lnminh1411/ESP32-Human-Presence-Radar/docs/images/pcb_base_silkscreen_bottom.png

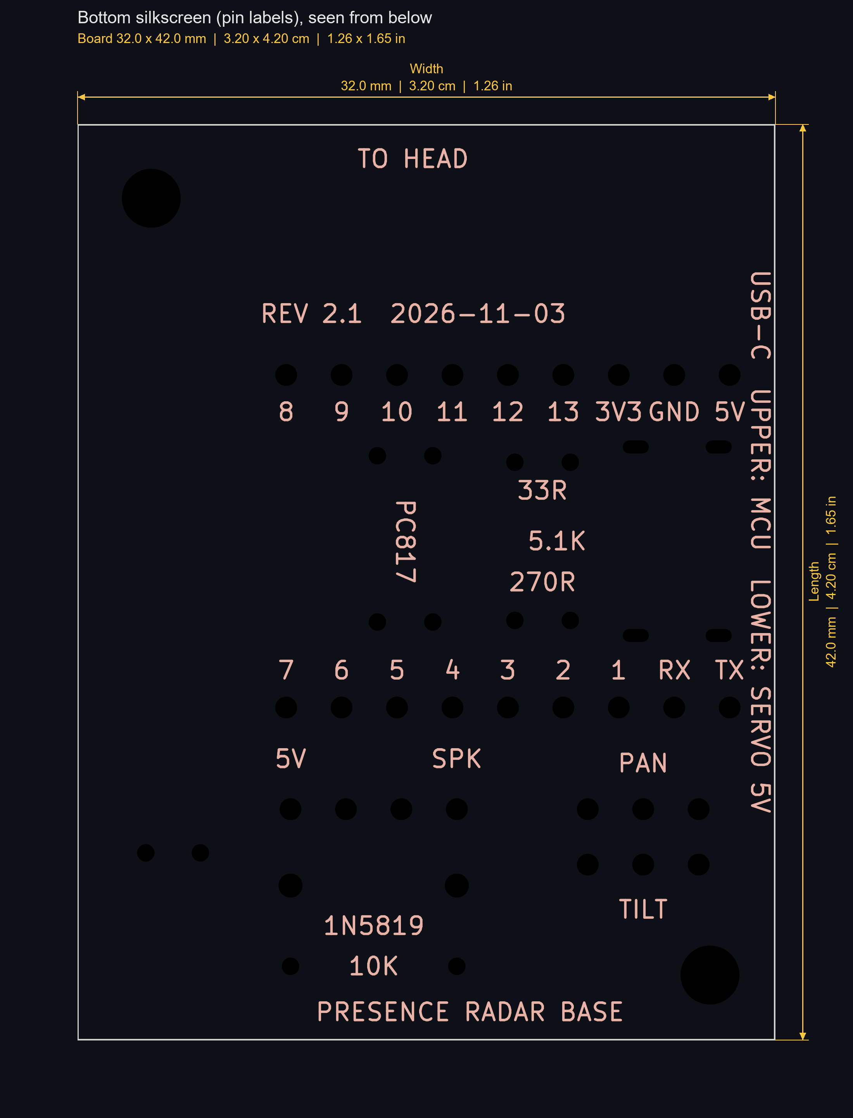
docs/images/pcb_base_silkscreen_bottom.png
