lnminh1411/ESP32-Human-Presence-Radar/docs/images/pcb_head_3d_sensor_side.png

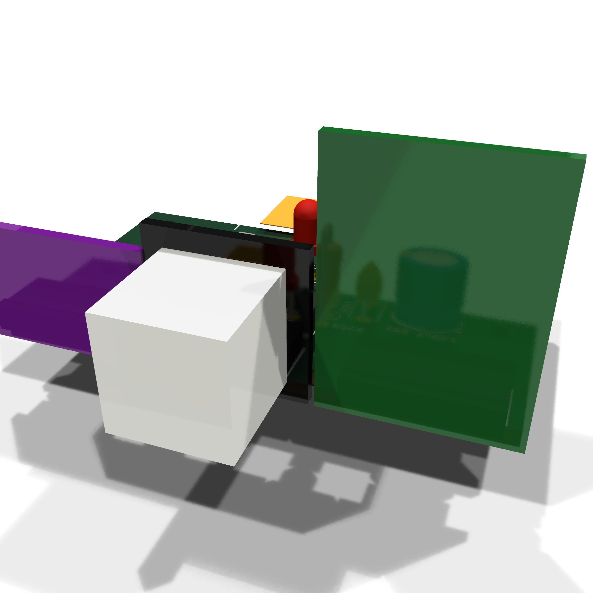
docs/images/pcb_head_3d_sensor_side.png
