lnminh1411/ESP32-Human-Presence-Radar/pcb/layouts/default/default.kicad_pcb

## KiCad design pcb/layouts/default/default.kicad_pcb (2026-11-03)

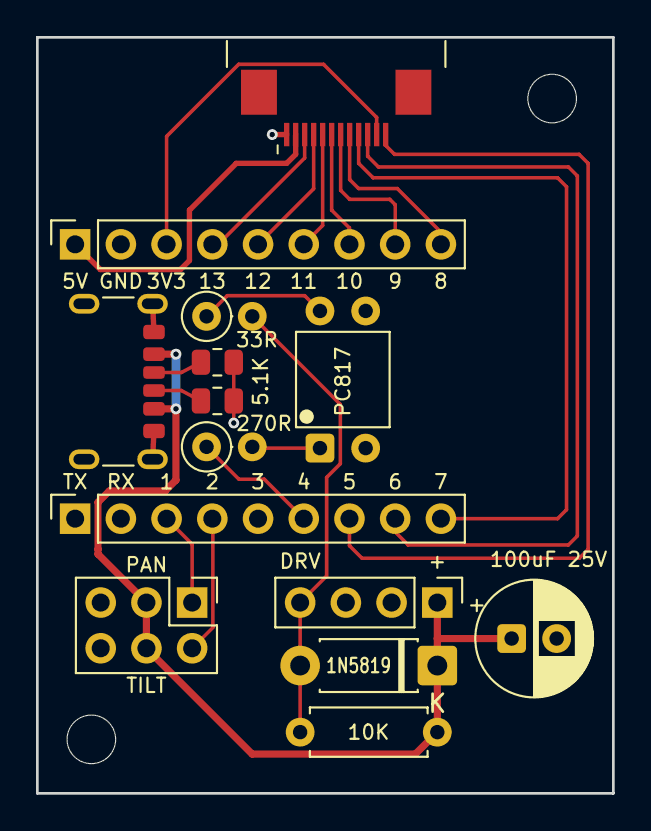
[picture p7: board default.kicad_pcb from above]

Board: 2 copper layers, 32.0 x 42.0 mm, 17 parts (0 on the bottom side), 21 nets.

Parts:
C1: 100u 25V; CP_Radial_D6.3mm_P2.50mm
D1: 1N5819; D_DO-41_SOD81_P7.62mm_Horizontal
FIT1: (no value)
J1, J2: main.ato:Socket1x9; PinSocket_1x09_P2.54mm_Vertical
J3: main.ato:Ffc12; FFC_P0.50mm_1x12_FlipLock_Bottom
J4: main.ato:ServoHeader2x3; PinHeader_2x03_P2.54mm_Vertical
J5: main.ato:UsbC6P; USB_C_Receptacle_GCT_USB4125-xx-x_6P_TopMnt_Horizontal
J6: main.ato:SpeakerHeader; PinHeader_1x04_P2.54mm_Vertical
MH1, MH2: MountingHole_2.7mm_M2.5
R1: 270; R_Axial_DIN0207_L6.3mm_D2.5mm_P2.54mm_Vertical
R2: 33; R_Axial_DIN0207_L6.3mm_D2.5mm_P2.54mm_Vertical
R3: 10k; R_Axial_DIN0207_L6.3mm_D2.5mm_P7.62mm_Horizontal
R4, R5: 5.1k; R_0805_2012Metric
U1: PC817; DIP-4_W7.62mm

Connections:
beep: J2.6, R1.1
beep_led: R1.2, U1.1
cc1: J5.A5, R4.1
cc2: J5.B5, R5.1
gnd: C1.2, J1.2, J3.1, J4.5, J4.6, J5.A12, J5.B12, J5.SH, R4.2, R5.2, U1.2, U1.3
led: J2.7, J3.12
opto_c: R2.1, U1.4
pir_out: J1.7, J3.6
radar_out: J1.4, J3.3
radar_rx: J1.5, J3.4
radar_tx: J1.6, J3.5
servo_5v: C1.1, D1.1, J4.3, J4.4, J5.A9, J5.B9, J6.1, R3.1
servo_pan: J2.3, J4.1
servo_tilt: J2.4, J4.2
spk_drive: D1.2, J6.4, R2.2, R3.2
tof_int: J1.9, J3.8
tof_scl: J2.8, J3.10
tof_sda: J2.9, J3.9
tof_xshut: J1.8, J3.7
v3v3: J1.3, J3.11
v5: J1.1, J3.2
