lnminh1411/ESP32-Human-Presence-Radar/pcb/layouts/head/head.kicad_pcb

## KiCad design pcb/layouts/head/head.kicad_pcb (2026-11-03)

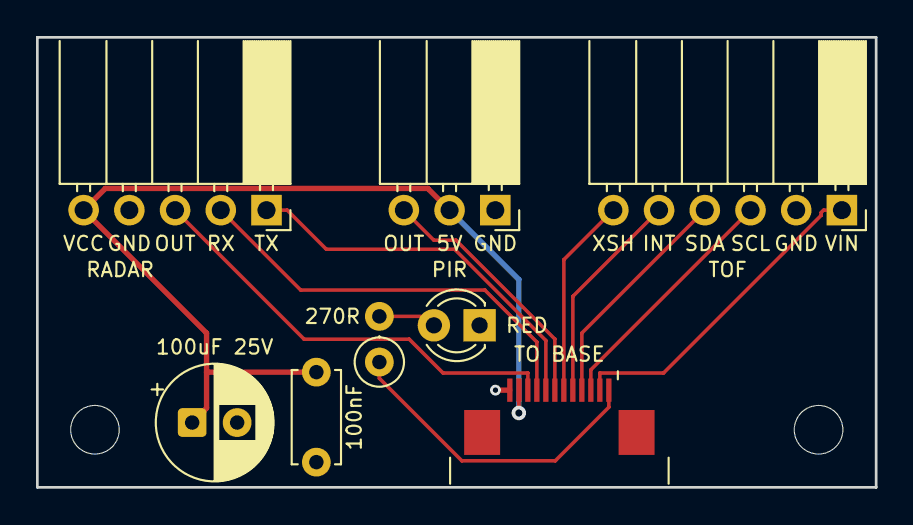
[picture p8: board head.kicad_pcb from above]

Board: 2 copper layers, 46.6 x 25.0 mm, 11 parts (0 on the bottom side), 13 nets.

Parts:
C1: 100u 25V; CP_Radial_D6.3mm_P2.50mm
C2: 100n; C_Disc_D5.0mm_W2.5mm_P5.00mm
D1: RED; LED_D3.0mm
FIT1: (no value)
J1: main.ato:RadarSocket; PinSocket_1x05_P2.54mm_Horizontal
J2: main.ato:TofSocket; PinSocket_1x06_P2.54mm_Horizontal
J3: main.ato:PirSocket; PinSocket_1x03_P2.54mm_Horizontal
J4: main.ato:Ffc12; FFC_P0.50mm_1x12_FlipLock_Bottom
MH1, MH2: MountingHole_2.7mm_M2.5
R1: 270; R_Axial_DIN0207_L6.3mm_D2.5mm_P2.54mm_Vertical

Connections:
gnd: C1.2, C2.2, D1.1, J1.4, J2.2, J3.1, J4.12
led: J4.1, R1.1
led_a: D1.2, R1.2
pir_out: J3.3, J4.7
radar_out: J1.3, J4.10
radar_rx: J1.2, J4.9
radar_tx: J1.1, J4.8
tof_int: J2.5, J4.5
tof_scl: J2.3, J4.3
tof_sda: J2.4, J4.4
tof_xshut: J2.6, J4.6
v3v3: J2.1, J4.2
v5: C1.1, C2.1, J1.5, J3.2, J4.11
