lnminh1411/ESP32-Human-Presence-Radar/Scripts/sync_netlist_to_board.py

"""
Sync atopile's exported KiCad-format netlist (pcb/build/<build>.net) onto
the board picked by PCB_BOARD (pcb/layouts/<build>/<build>.kicad_pcb), using
only KiCad's own bundled pcbnew Python API -- no GUI automation, no
xdotool/Docker/X11 (kicad_cli, the pierrechevalier83 tool, can't do this
at all -- it only runs ERC/DRC on an already-existing project, it doesn't
import netlists or place footprints). kicad-cli (KiCad's own official
CLI) doesn't have a netlist-import command either; this script is the
actual missing piece, built directly on pcbnew's scripting API.

Run this after every `ato build` that changes main.ato's parts or nets.

IDEMPOTENT: a component reference (U1, U2, ...) that already exists on
the board keeps its current position/rotation -- only its pad-net
assignments get refreshed. A brand-new reference (a part just added to
main.ato) gets grid-placed in open space so it doesn't get lost, but
its position is NOT considered final -- move it via the KiCad GUI same
as anything else. A reference that's on the board but no longer in the
netlist (a part removed from main.ato) is left in place with a warning
printed, not silently deleted -- deleting real placement/routing work
automatically is exactly the kind of thing that should require a human
look first.

All nets are rebuilt from scratch each run (old NETINFO_ITEMs cleared,
new ones created from the current netlist) since net topology is fully
derived from main.ato and should always just reflect current truth --
there's nothing per-net worth preserving across a re-sync the way
placement is.

Usage:
    cd pcb && PYTHONIOENCODING=utf-8 ato build
    <kicad-python> Scripts/sync_netlist_to_board.py
(must run under KiCad's own bundled Python -- that's the only one with
the pcbnew module installed.)
"""
import re
import pcbnew
import os
from board_config import BOARD, BOARD_PATH, KICAD_FOOTPRINTS as FPBASE, NET_PATH, ROOT

# Board references come from the atopile INSTANCE name, not atopile's own
# U1..Un numbering: that is pure declaration order, so adding or removing a
# part would renumber every part after it (and every ref-keyed placement in
# layout_<board>.py with it). Instance names only change when main.ato says so.
REF_BY_INSTANCE = {
    "base": {"mcu.a": "J1", "mcu.b": "J2", "ffc": "J3", "servos": "J4", "servo_in": "J5",
             "spk": "J6", "c1": "C1", "opto": "U1", "r_led": "R1", "r_spk": "R2",
             "r_dis": "R3", "r_cc1": "R4", "r_cc2": "R5", "d1": "D1"},
    "head": {"radar": "J1", "tof": "J2", "pir": "J3", "ffc": "J4", "c1": "C1", "c2": "C2",
             "led1": "D1", "r_led": "R1"},
}[BOARD]
LOCAL_LIBS = {"PresenceRadar": os.path.join(ROOT, "pcb", "footprints", "PresenceRadar.pretty")}


def board_ref(inst):
    if inst in REF_BY_INSTANCE:
        return REF_BY_INSTANCE[inst]
    raise SystemExit(f"no board reference for atopile instance {inst!r} -- add it to REF_BY_INSTANCE")


# atopile 0.2 drops `value`, so part values are keyed off the instance name
INSTANCE_VALUES = {
    "base": {"c1": "100u 25V", "opto": "PC817", "r_led": "270", "r_spk": "33", "r_dis": "10k",
             "d1": "1N5819", "r_cc1": "5.1k", "r_cc2": "5.1k"},
    "head": {"c1": "100u 25V", "c2": "100n", "led1": "RED", "r_led": "270"},
}[BOARD]


def parse_netlist(path):
    with open(path, encoding="utf-8") as f:
        text = f.read()

    comp_re = re.compile(
        r'\(comp \(ref "(?P<ref>[^"]+)"\).*?\(footprint "(?P<fp>[^"]+)"\).*?'
        r'\(description "(?P<desc>[^"]*)"\).*?\(names "[^"]*::(?P<inst>[^"]+)"\)',
        re.DOTALL,
    )
    components = {}
    for m in comp_re.finditer(text):
        desc = INSTANCE_VALUES.get(m.group("inst"), m.group("desc"))
        components[m.group("ref")] = {"footprint": m.group("fp"), "desc": desc,
                                      "board_ref": board_ref(m.group("inst"))}

    nets_section = text[text.index("(nets"):]
    net_start_re = re.compile(r'\(net \(code "(\d+)"\) \(name "([^"]*)"\)')
    node_re = re.compile(r'\(node \(ref "([^"]+)"\) \(pin "([^"]+)"\)')
    nets = []
    for sm in net_start_re.finditer(nets_section):
        code, name = sm.groups()
        # Paren-depth scan, not a naive non-greedy regex: a `.*?\)\)`
        # match stops at the end of the FIRST node (whose own closing
        # "))" looks identical to the net's), silently truncating every
        # net with more than one node. Confirmed the hard way once
        # already -- don't regress this.
        i = sm.end()
        depth = 1
        while depth > 0:
            if nets_section[i] == "(":
                depth += 1
            elif nets_section[i] == ")":
                depth -= 1
            i += 1
        body = nets_section[sm.end():i]
        nodes = node_re.findall(body)
        nets.append((code, name, nodes))

    return components, nets


def place_new_footprint(fp, cursor):
    """Place a brand-new footprint at cursor=[x, y, row_h] (mutated in
    place), accounting for the gap between a footprint's anchor and its
    own bounding box -- placing the raw anchor at the cursor leaves tall
    parts (e.g. a 44-pin header) overlapping neighboring rows, since the
    anchor sits near pad 1, nowhere near the bbox center."""
    max_x = pcbnew.FromMM(280)
    margin = pcbnew.FromMM(5)

    fp.SetPosition(pcbnew.VECTOR2I(0, 0))
    bbox0 = fp.GetBoundingBox()
    offset = pcbnew.VECTOR2I(-bbox0.GetLeft(), -bbox0.GetTop())
    w, h = bbox0.GetWidth(), bbox0.GetHeight()

    if cursor[0] + w > max_x:
        cursor[0] = pcbnew.FromMM(20)
        cursor[1] += cursor[2] + margin
        cursor[2] = pcbnew.FromMM(0)

    fp.SetPosition(pcbnew.VECTOR2I(cursor[0], cursor[1]) + offset)
    cursor[0] += w + margin
    cursor[2] = max(cursor[2], h)


def main():
    components, nets = parse_netlist(NET_PATH)
    print(f"netlist: {len(components)} components, {len(nets)} nets, "
          f"{sum(len(n[2]) for n in nets)} pad-net links")

    board = pcbnew.LoadBoard(BOARD_PATH)
    existing = {fp.GetReference(): fp for fp in board.GetFootprints()}

    # cursor continues past whatever's already placed, so newly-added
    # parts don't land on top of existing (possibly manually-placed) ones
    cursor = [pcbnew.FromMM(20), pcbnew.FromMM(20), pcbnew.FromMM(0)]
    if existing:
        max_bottom = max(fp.GetBoundingBox().GetBottom() for fp in existing.values())
        cursor[1] = max_bottom + pcbnew.FromMM(20)

    placed = {}
    new_count = 0
    for net_ref in sorted(components, key=lambda r: int(r[1:])):
        info = components[net_ref]
        ref = info["board_ref"]
        if ref in existing:
            placed[ref] = existing[ref]
            continue
        lib, name = info["footprint"].split(":", 1)
        libdir = LOCAL_LIBS.get(lib, f"{FPBASE}\\{lib}.pretty")
        fp = pcbnew.FootprintLoad(libdir, name)
        if fp is None:
            print(f"  ! could not load footprint {info['footprint']} for {ref}")
            continue
        fp.SetReference(ref)
        fp.SetValue(info["desc"])
        place_new_footprint(fp, cursor)
        board.Add(fp)
        placed[ref] = fp
        new_count += 1
    # netlist nodes name atopile's refs; map them to the placed footprints
    placed_by_net_ref = {r: placed[c["board_ref"]] for r, c in components.items()
                         if c["board_ref"] in placed}

    stale = set(existing) - {c["board_ref"] for c in components.values()}
    for ref in sorted(stale):
        print(f"  ! {ref} is on the board but no longer in the netlist "
              f"-- left in place, remove it by hand if it's really gone")

    print(f"placed {new_count} new footprint(s), reused {len(placed) - new_count} existing")

    # Reuse an existing net by name rather than clearing+recreating every
    # NETINFO_ITEM up front -- removing board-owned NETINFO_ITEMs while
    # other live Python objects still reference related structures trips
    # a SWIG object-lifetime bug (confirmed the hard way: pad wrappers
    # came back as raw, useless SwigPyObjects afterwards). A pad whose
    # net legitimately changed just gets reassigned below; a pad on a net
    # that's genuinely gone from the netlist keeps its last assignment
    # until someone re-runs a real KiCad netlist diff -- acceptable given
    # this script's job is "get everything current onto the board", not
    # "perfectly mirror every deletion".
    pad_count = 0
    for code, name, nodes in nets:
        net_name = name if name and not name.startswith("net") else f"N${code}"
        netinfo = board.FindNet(net_name)
        if netinfo is None:
            netinfo = pcbnew.NETINFO_ITEM(board, net_name)
            board.Add(netinfo)
        for ref, pin in nodes:
            fp = placed_by_net_ref.get(ref)
            if fp is None:
                continue
            # every pad with that number: a USB-C shell has four "SH" legs
            pads = [p for p in fp.Pads() if p.GetNumber() == pin]
            if not pads:
                print(f"  ! {ref} has no pad numbered {pin!r} (net {net_name})")
                continue
            for pad in pads:
                pad.SetNet(netinfo)
                pad_count += 1

    print(f"assigned {pad_count} pad-net links")

    pcbnew.SaveBoard(BOARD_PATH, board)
    print("saved", BOARD_PATH)


if __name__ == "__main__":
    main()
