lnminh1411/ESP32-Human-Presence-Radar/(commit log)

2026-11-02 docs: start ESP32 Human Presence Radar repo
    Design decisions from 2026-11-02: S3 SuperMini + LD2410C-P + VL53L1X
    board, ESP-NOW to the ESP32 PC Controller main board, USB to PcHwCtl,
    USB identity (VID 0x303A, PID 0x8F52, WinUSB GUID), shelf-front tilted
    mount. Adds README, docs/design.md, docs summary, wiki, scripts index.
    Assisted by Claude Code
2026-11-02 docs: mark ESP32 PC Control System as the main project
    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
2026-11-02 docs: note broken RST button on the SuperMini
    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
2026-11-02 feat(pcb): rev 1.1 presence board, netlist to Gerbers
    - pcb/main.ato: SuperMini, LD2410C-P and VL53L1X sockets, boost on a
    soldered header with JP1 picking the radar supply, 100u + 100n on the
    radar 5V; radar on GPIO5/6/7, ToF on GPIO10-13
    - Scripts/: KiCad + Freerouting chain ported from the ESP32 PC Controller
    carrier (blank board, netlist sync, layout, pours, routing, chamfer,
    renders, Gerbers)
    - rev 1.1 layout: 38.5 x 33.5 mm, SuperMini sideways with USB-C west,
    boost/C2/JP1 under it, C1 lying flat, all routing on F.Cu, DRC 0/0
    - lying 6.3 mm electrolytic footprint, fit-check 3D models, renders
    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
    [default.kicad_pcb]
2026-11-02 feat(pcb): rev 1.1 top silkscreen labels and socket outlines
    - top silk: one label per pad on every socket, boost and JP1, plus
    BOOST/C2 marks; bottom labels kept for when the modules cover the top
    - right-angle sensor sockets: stock silk moved to F.Fab, body outline
    redrawn on the board side, cut at the north edge
    - JP1, C2 and boost 0.4 mm south so labels clear the socket outlines
    - socket outline box computed from floats: BOX2I.Merge tripped a
    kimath overflow assert that hung pcbnew on a hidden dialog
    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
    [default.kicad_pcb]
2026-11-02 feat(pcb): rev 1.2 sensors at the edges, stock socket silk
    ToF socket moved into the north-west corner, north-west mounting hole
    moved between the sensors. Right-angle sockets keep their stock silk
    (line per pin, pin-1 hatch) clipped at the board edge. DRC 0/0.
    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
    [default.kicad_pcb]
2026-11-02 docs: dedicated presence camera on its own USB cable
    USB (UVC) camera takes over PcHwCtl's presence check so the webcam stays
    free. Camera and board each run on their own backpanel USB 2.0 port; no
    hub, no PCB change (rev 1.2 stands). Records why splitters, an on-board
    hub and a USB-UART path were ruled out.
    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
2026-11-02 docs: drop the dedicated camera and the thermal array
    Radar and ToF take over routine presence; the PC webcam and NPU stay for
    face recognition and normal use. Camera findings (GPIO, USB, cabling) kept
    in case it returns. AMG8833 thermal array dropped: the cheap listing was a
    pricing error. Also carries the open-item and summary notes about the
    architecture docs moving to the ESP32 PC Control System folder.
    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
2026-11-02 docs(pcb): chosen C1 and C2 parts, C1 rated 25 V
    C1 is a 100 uF / 25 V electrolytic (10 V minimum), C2 a 104 / 50 V
    ceramic disc seated flush under the SuperMini. C1 value updated in
    main.ato, the netlist sync and the board (F.Fab only, Gerbers unchanged).
    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
    [default.kicad_pcb]
2026-11-03 feat(pcb): rev 1.3 SR602 PIR, rear USB 3.2 Gen 1 port
    SR602 mini PIR (J5) on a right-angle socket between ToF and radar, OUT
    on GPIO8, fed from radar_5v. It vetoes radar motion with no warm body
    behind it (fan beside the chair). Board 46.6 x 36.5 mm: radar and C1
    moved 8.1 mm east, holes moved to the south-west corner and east edge.
    Radar TX/OUT cross radar_5v on B.Cu (one via). DRC 0/0, Gerbers built.
    Board now plugs into a rear USB 3.2 Gen 1 port (900 mA). Firmware
    presence rules recorded in docs/design.md.
    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
    [default.kicad_pcb]
2026-11-03 feat(pcb): rev 2.0 two boards, base + sensor head on a pan-tilt
    Split the presence PCB into a fixed base and a sensor head on two SG90
    servos, joined by a 12-pin 0.5 mm FFC, so the servos never pull a USB
    cable.
    - Base 32.0 x 42.0 mm: SuperMini, servo 2x3 header, 6-pin USB-C for the
    servo 5V under the SuperMini's own (5.1k CC pull-downs), PC817 piezo
    beeper. Boost and JP1 dropped.
    - Head 46.6 x 21.0 mm: radar, PIR, ToF on right-angle sockets, 100u/100n
    on the radar 5V.
    - New pin map so the FFC fans straight into the module rows.
    - Chain is board-aware (PCB_BOARD), build_board.py runs it end to end,
    layout_common.py holds shared helpers and locked pre-routes.
    - DRC 0/0 on both boards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
    [default.kicad_pcb, head.kicad_pcb]
2026-11-03 test: servo bench script and results
    Scripts/bench.py drives the bench tests; docs/bringup.md records the
    SG90 servo test, with matching Wiki, Scripts.md and docs summary lines.
    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
2026-11-03 docs: fix bringup path in design.md, servo GPIO note for rev 2.0
2026-11-03 feat(pcb): rev 2.1 red LED behind the PIR, part values on silkscreen
    - Head: red 3 mm LED (D1) + 270R (R1) right behind the PIR, driven by
    GPIO5 over FFC base pin 12 / head pin 1 (was the second GND). Head
    grows to 46.6 x 25.0 mm; C2 stands north-south.
    - Base: LED line pre-routed outside the I2C pair to GPIO5; FFC pin-12
    GND stitch dropped. U1 moved 1 mm east to make room for value text.
    - Silkscreen: every part's value printed on top next to it (refs
    hidden), under-module values repeated on the bottom.
    - Docs: FFC table, cable check (wrong-type cable no longer harmless),
    GPIO map, parts, renders.
    Both boards DRC 0/0.
    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
    [default.kicad_pcb, head.kicad_pcb]
2026-11-03 feat(pcb): base D1 1N4007 -> 1N5819 Schottky
    Same DO-41 holes. Faster turn-off at the 2-4 kHz beep tone and a lower
    clamp (~0.45 V). Silkscreen, netlist value and docs updated; base DRC 0/0.
    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
    [default.kicad_pcb]
2026-11-03 feat(pcb): base tracks to east edge, PC817 dot + in-body values
    - I2C pair and head LED line run down the east edge (x 29.4-30.6), clear
    of the SuperMini's pin 8/9 ends for soldering.
    - PC817 silk: notch outline replaced by a plain box with a pin-1 dot
    (PC Controller convention, matches the moulded dot).
    - 1N5819 value printed inside the diode body; text() takes a glyph width.
    Base DRC 0/0.
    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
    [default.kicad_pcb]
